bartpleiter/ESPGI/PCB/schematic.pdf

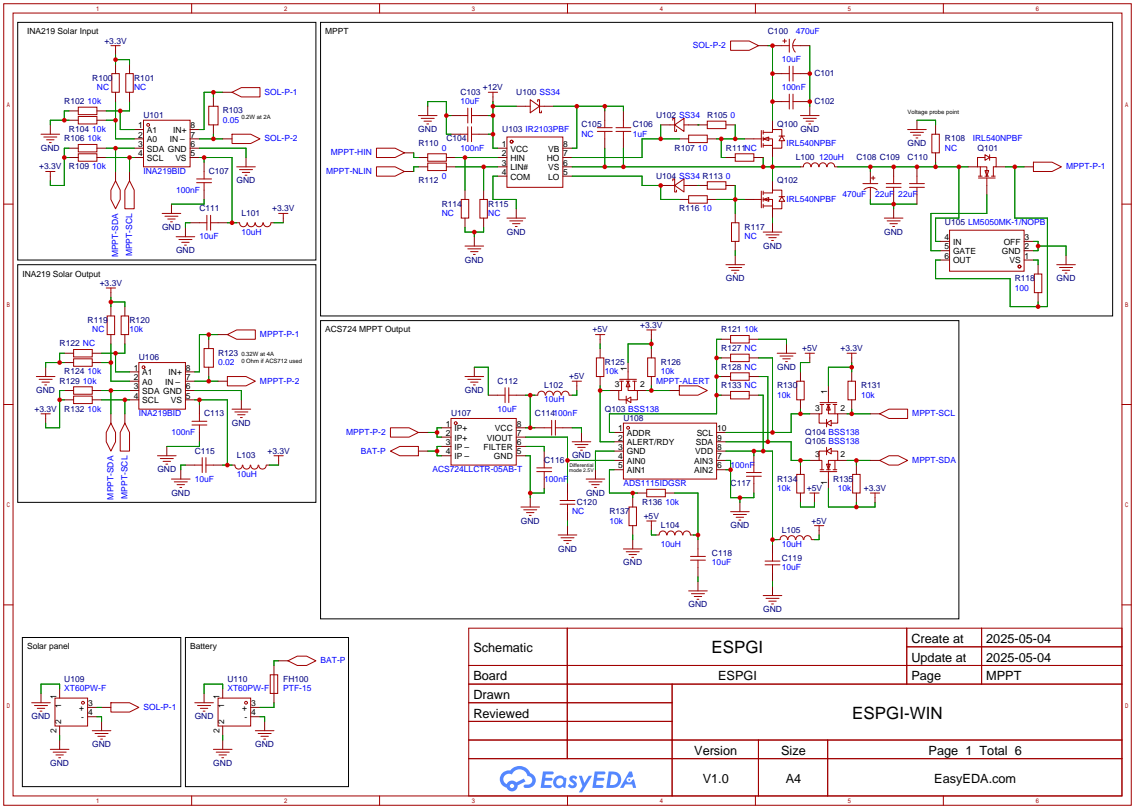
[picture p3: page 1]

Schematic | ESPGI | Create at | 2025-05-04

Update at | 2025-05-04

Board | ESPGI | Page | MPPT
Drawn | | ESPGI-WIN
Reviewed

Version | Size | Page 1 Total 6
V1.0 | A4 | EasyEDA.com

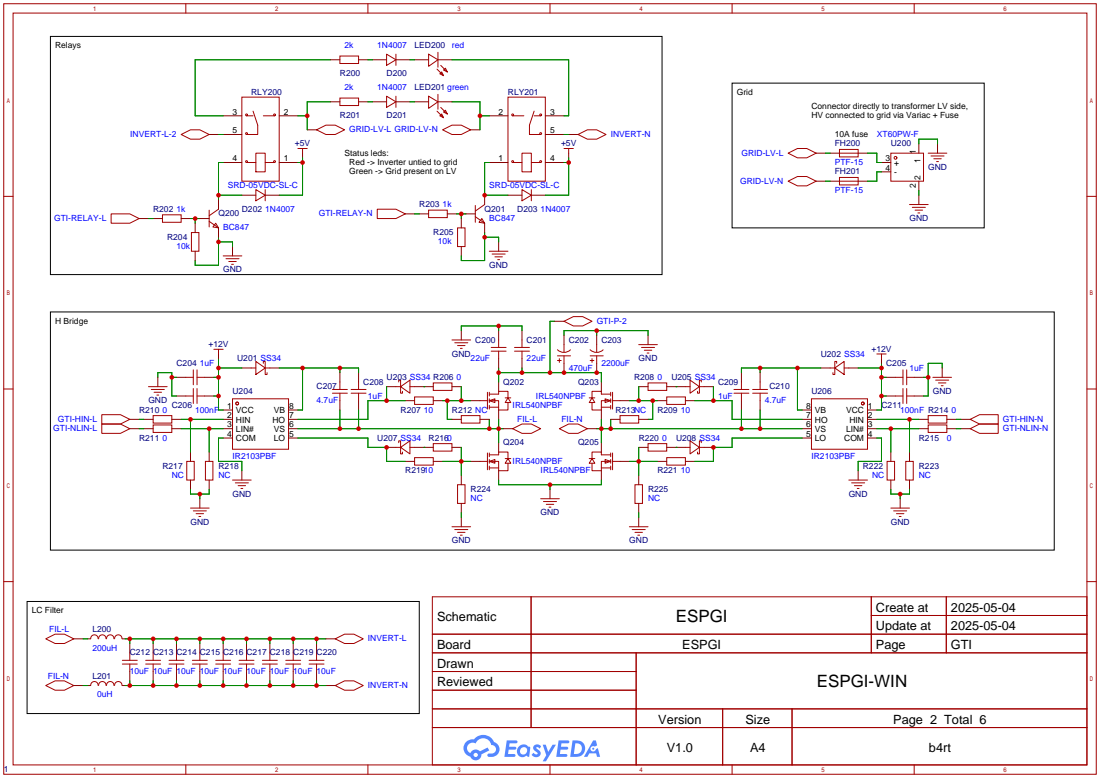
[picture p4: page 2]

Connector directly to transformer LV side,
HV connected to grid via Variac + Fuse
10A fuse
PTF-15

Status leds:
Red -> Inverter untied to grid
Green -> Grid present on LV

Schematic | ESPGI | Create at | 2025-05-04

Update at | 2025-05-04

Board | ESPGI | Page | GTI
Drawn | | ESPGI-WIN
Reviewed

Version | Size | Page 2 Total 6
V1.0 | A4 | b4rt

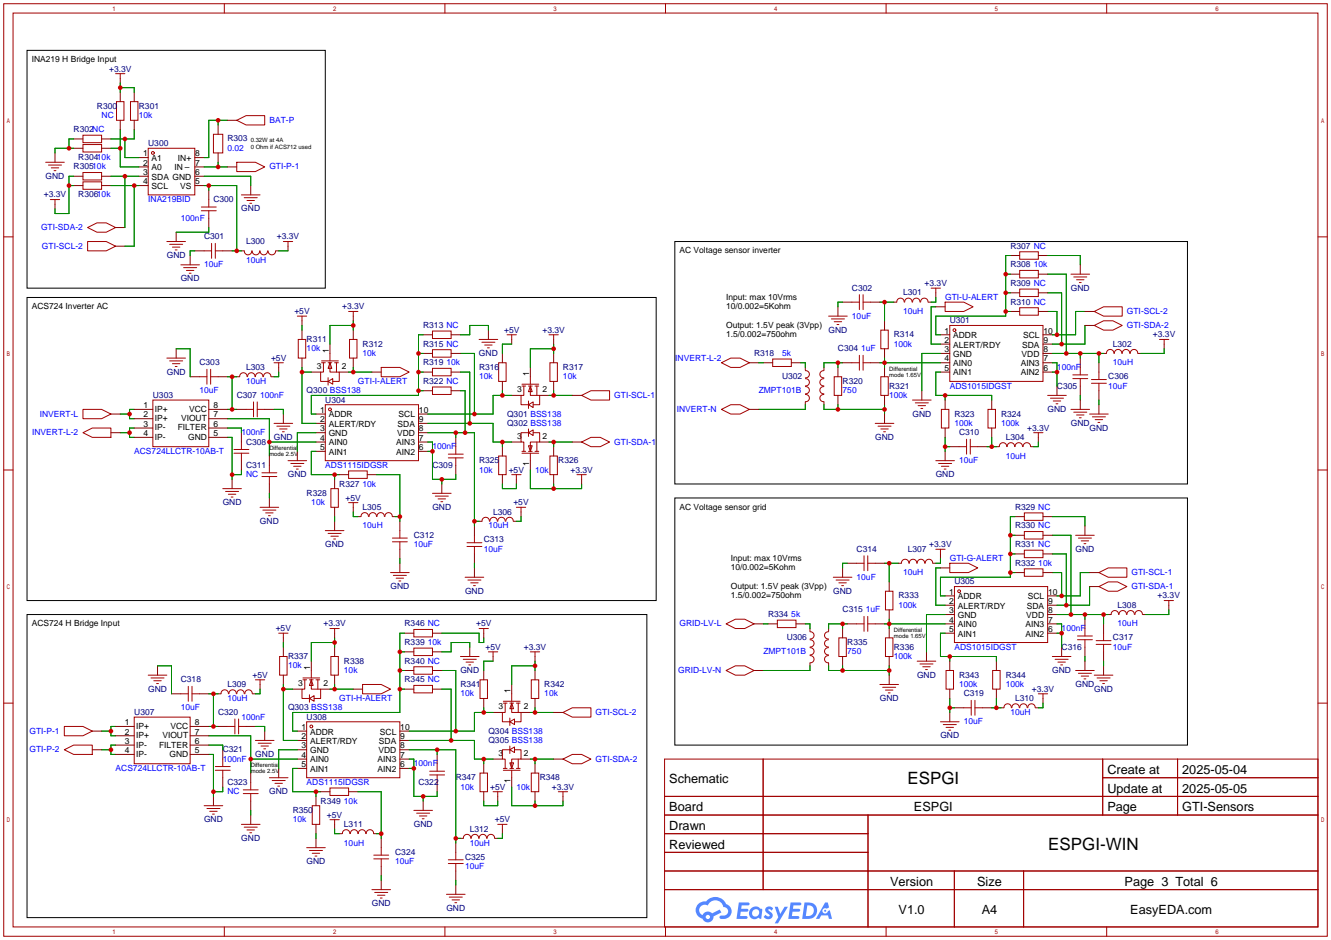
[picture p5: page 3]

AC Voltage sensor inverter

AC Voltage sensor grid

Schematic | ESPGI | Create at | 2025-05-04

Update at | 2025-05-05

Board | ESPGI | Page | GTI-Sensors
Drawn | | ESPGI-WIN
Reviewed

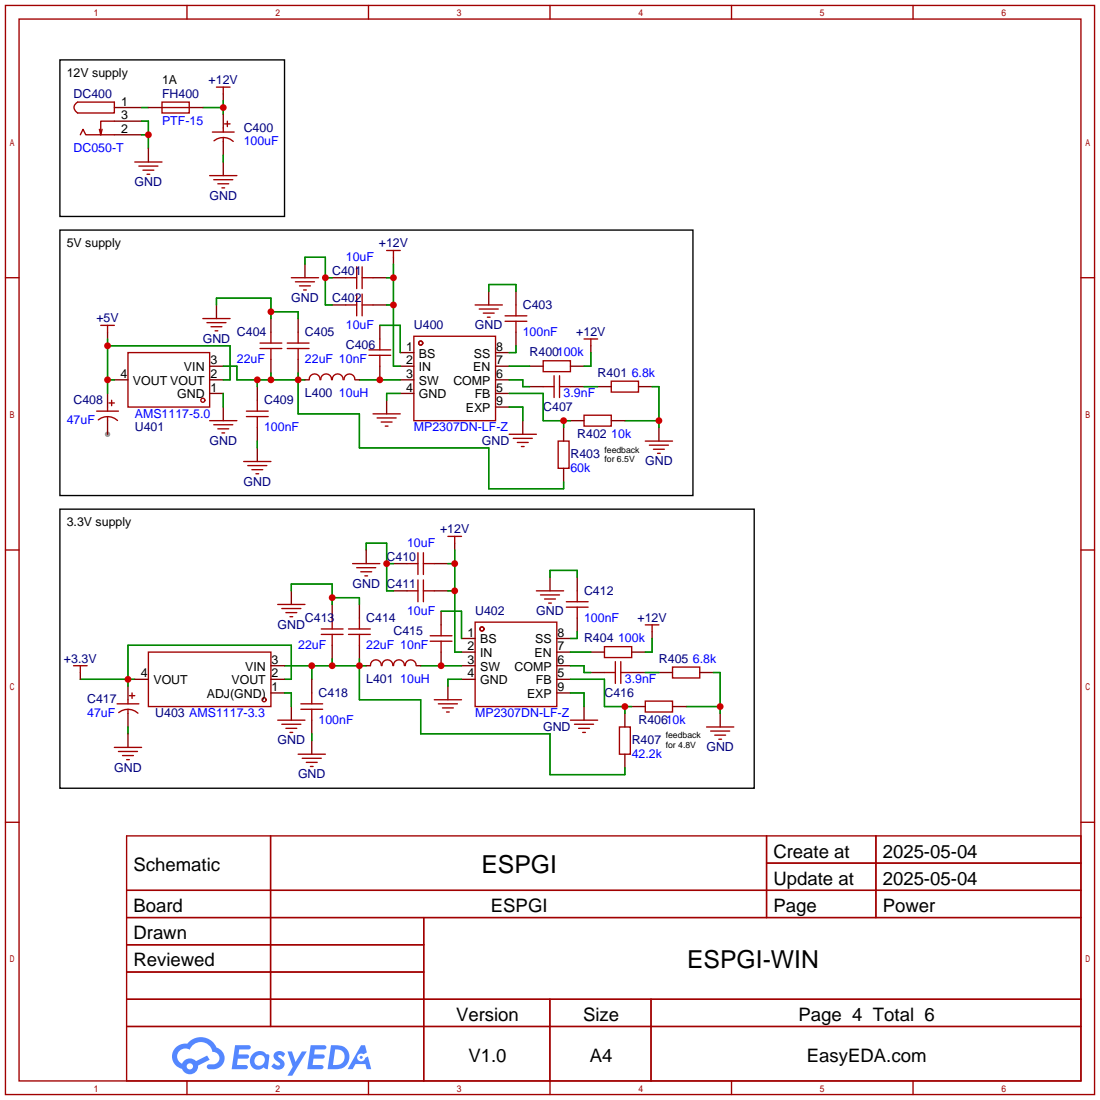
[picture p6: page 4]

Schematic | ESPGI | Create at | 2025-05-04

Update at | 2025-05-04

Board | ESPGI | Page | Power
Drawn | | ESPGI-WIN
Reviewed

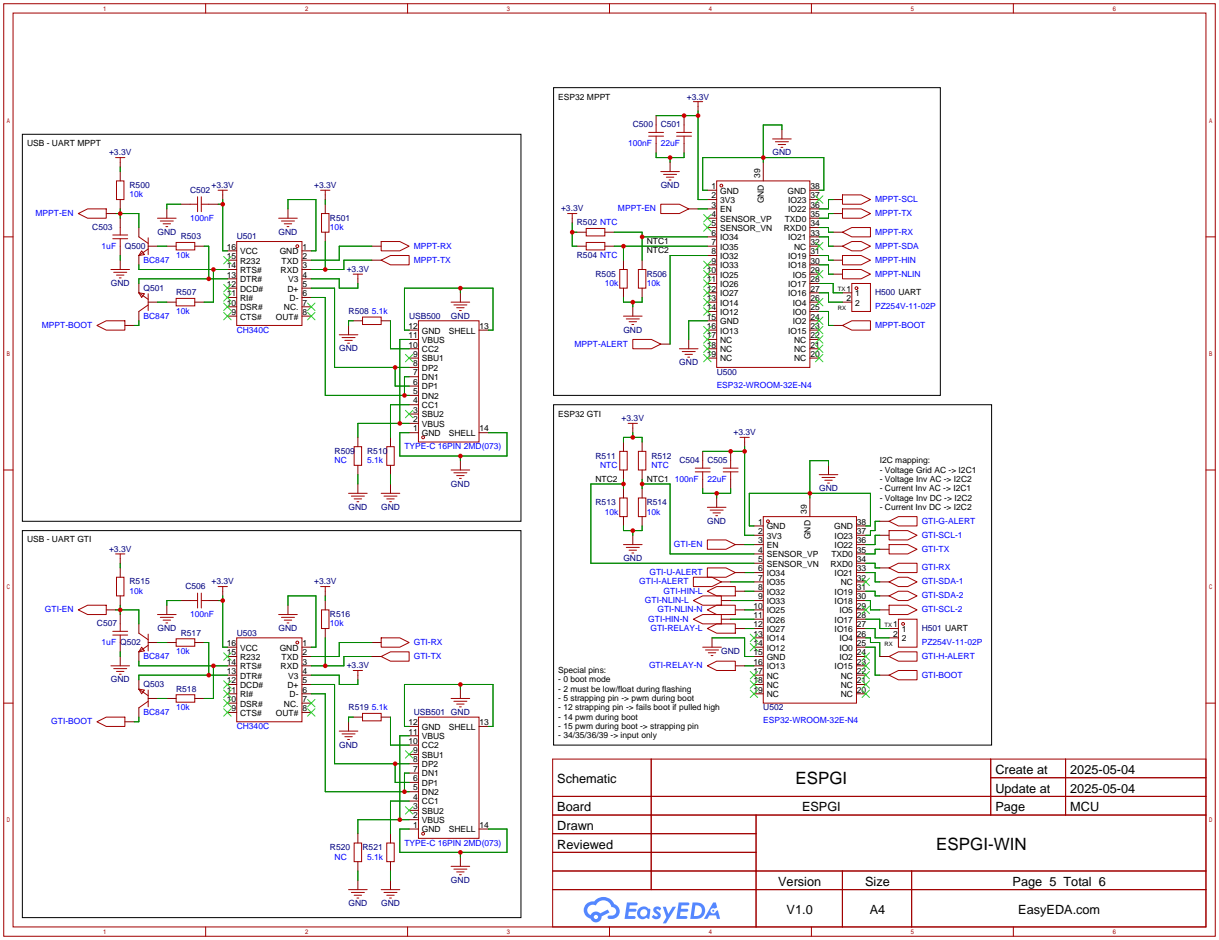
[picture p7: page 5]

DSR# 10 RI# 11 DCD# 12 DTR# 13 RTS# 14 R232 15 VCC 16

Special pins:
- 0 boot mode
- 2 must be low/float during flashing
- 5 strapping pin -> pwm during boot
- 12 strapping pin -> fails boot if pulled high
- 14 pwm during boot
- 15 pwm during boot -> strapping pin
- 34/35/36/39 -> input only

Schematic | ESPGI | Create at | 2025-05-04

Update at | 2025-05-04

Board | ESPGI | Page | MCU
Drawn | | ESPGI-WIN
Reviewed

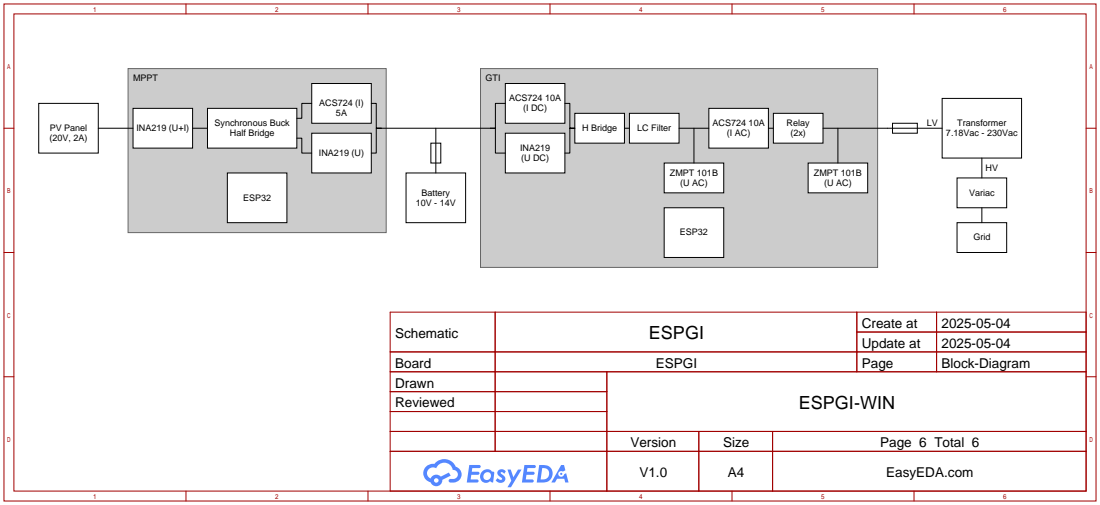
[picture p8: page 6]

Schematic | ESPGI | Create at | 2025-05-04

Update at | 2025-05-04

Board | ESPGI | Page | Block-Diagram
Drawn | | ESPGI-WIN
Reviewed
