bartpleiter/ESPGI/(list of files, drawings)

Other design files:
PCB/ESPGI-WIN.eprj
