bartpleiter/ESPGI/(commit log)

2025-06-05 feat: initial upload.
    [ESPGI-WIN.eprj]
2025-06-05 fix: properly add GTI subproject.
    [config.h, grid_control.cpp, grid_control.h, hardware.cpp, hardware.h, main.cpp, pwm_control.cpp]
2025-06-05 feat: add bottom view pcb to readme.
2025-06-08 feat: updated for 4s lifepo4 battery.
2025-06-14 feat: disable pwm output when not connected, add voltage threshold for grid tie to prevent quick disconnect after connect.
    [config.h, grid_control.cpp, grid_control.h, pwm_control.cpp]
2025-06-21 feat: sensor calibration at no current.
